MSF3Dprinting/SiliconeTubeDryingHolder/tools/sweep_report_2026-09-27.txt

# Parameter sweep — tube_holder.scad v2.0 — 2026-09-27 (openscad-fast Manifold + check_stl, sections Z 3,10,40,50)
# Every parameter at its min and max, one at a time; run in chunks and merged. GUARD = the model stopped itself with a
# plain-language assertion at that range end; PASS = exported, watertight, 1 body, checks OK. edge_r=max(3) first failed
# (the cove ring stood 0.55 mm off the sliced edge rounding); the cove profile now reaches 1 mm into the shelf — re-run PASS.
PASS   defaults                                    5.2s  check_stl warn: section at Z = 40.0: 6 separate pieces — expected if the part has several legs or walls here, a defect if the zone should be one piece; section at Z = 50.0: 6 separate pieces — expected if the part has several legs or walls here, a defect if the zone should be one piece
PASS   slot_n=min(1)                               2.4s  check_stl warn: section at Z = 40.0: 2 separate pieces — expected if the part has several legs or walls here, a defect if the zone should be one piece; section at Z = 50.0: 2 separate pieces — expected if the part has several legs or walls here, a defect if the zone should be one piece
GUARD  slot_n=max(8)                               0.4s  ERROR: Assertion '(((W <= (max_part[0] + 0.001)) && (plate_h <= max_part[1])) && ((plate_t + D) <= max_part[2]))' failed: "Part larger than 200 mm: fewer slots or a smaller pitch" in file /work/tube_holder.scad, line 122
PASS   slot_pitch=min(20)                          5.1s  check_stl warn: section at Z = 40.0: 6 separate pieces — expected if the part has several legs or walls here, a defect if the zone should be one piece; section at Z = 50.0: 6 separate pieces — expected if the part has several legs or walls here, a defect if the zone should be one piece
GUARD  slot_pitch=max(50)                          0.4s  ERROR: Assertion '(((W <= (max_part[0] + 0.001)) && (plate_h <= max_part[1])) && ((plate_t + D) <= max_part[2]))' failed: "Part larger than 200 mm: fewer slots or a smaller pitch" in file /work/tube_holder.scad, line 122
GUARD  pocket_1=min(3)                             0.4s  ERROR: Assertion '(pocket_d[k] > (pocket_d[(k + 1)] + 0.5))' failed: "pocket_d must go from the biggest tube (mouth) to the smallest (wall), each at least 0.5 mm smaller" in file /work/tube_holder.scad, line 107
PASS   pocket_1=max(16)                            5.2s  check_stl warn: section at Z = 40.0: 6 separate pieces — expected if the part has several legs or walls here, a defect if the zone should be one piece; section at Z = 50.0: 6 separate pieces — expected if the part has several legs or walls here, a defect if the zone should be one piece
GUARD  pocket_2=min(3)                             0.4s  ERROR: Assertion '(pocket_d[k] > (pocket_d[(k + 1)] + 0.5))' failed: "pocket_d must go from the biggest tube (mouth) to the smallest (wall), each at least 0.5 mm smaller" in file /work/tube_holder.scad, line 107
GUARD  pocket_2=max(16)                            0.4s  ERROR: Assertion '(pocket_d[k] > (pocket_d[(k + 1)] + 0.5))' failed: "pocket_d must go from the biggest tube (mouth) to the smallest (wall), each at least 0.5 mm smaller" in file /work/tube_holder.scad, line 107
GUARD  pocket_3=min(3)                             0.4s  ERROR: Assertion '(pocket_d[k] > (pocket_d[(k + 1)] + 0.5))' failed: "pocket_d must go from the biggest tube (mouth) to the smallest (wall), each at least 0.5 mm smaller" in file /work/tube_holder.scad, line 107
GUARD  pocket_3=max(16)                            0.4s  ERROR: Assertion '(pocket_d[k] > (pocket_d[(k + 1)] + 0.5))' failed: "pocket_d must go from the biggest tube (mouth) to the smallest (wall), each at least 0.5 mm smaller" in file /work/tube_holder.scad, line 107
PASS   pocket_4=min(2)                             5.1s  check_stl warn: section at Z = 40.0: 6 separate pieces — expected if the part has several legs or walls here, a defect if the zone should be one piece; section at Z = 50.0: 6 separate pieces — expected if the part has several legs or walls here, a defect if the zone should be one piece
GUARD  pocket_4=max(16)                            0.4s  ERROR: Assertion '(pocket_d[k] > (pocket_d[(k + 1)] + 0.5))' failed: "pocket_d must go from the biggest tube (mouth) to the smallest (wall), each at least 0.5 mm smaller" in file /work/tube_holder.scad, line 107
PASS   squeeze_top=min(2)                          5.1s  check_stl warn: section at Z = 40.0: 6 separate pieces — expected if the part has several legs or walls here, a defect if the zone should be one piece; section at Z = 50.0: 6 separate pieces — expected if the part has several legs or walls here, a defect if the zone should be one piece
PASS   squeeze_top=max(12)                         4.9s  check_stl warn: section at Z = 40.0: 6 separate pieces — expected if the part has several legs or walls here, a defect if the zone should be one piece; section at Z = 50.0: 6 separate pieces — expected if the part has several legs or walls here, a defect if the zone should be one piece
GUARD  squeeze_bottom=min(4)                       0.4s  ERROR: Assertion '(squeeze_bottom > squeeze_top)' failed: "squeeze_bottom must be larger than squeeze_top (the pocket narrows toward the bottom face)" in file /work/tube_holder.scad, line 108
PASS   squeeze_bottom=max(20)                      5.2s  check_stl warn: section at Z = 40.0: 6 separate pieces — expected if the part has several legs or walls here, a defect if the zone should be one piece; section at Z = 50.0: 6 separate pieces — expected if the part has several legs or walls here, a defect if the zone should be one piece
PASS   pocket_extra=min(2)                        10.6s  check_stl warn: section at Z = 40.0: 6 separate pieces — expected if the part has several legs or walls here, a defect if the zone should be one piece; section at Z = 50.0: 6 separate pieces — expected if the part has several legs or walls here, a defect if the zone should be one piece
PASS   shelf_t=min(12)                             5.1s  check_stl warn: section at Z = 40.0: 6 separate pieces — expected if the part has several legs or walls here, a defect if the zone should be one piece; section at Z = 50.0: 6 separate pieces — expected if the part has several legs or walls here, a defect if the zone should be one piece
PASS   shelf_t=max(26)                             5.2s  check_stl warn: section at Z = 40.0: 6 separate pieces — expected if the part has several legs or walls here, a defect if the zone should be one piece; section at Z = 50.0: 6 separate pieces — expected if the part has several legs or walls here, a defect if the zone should be one piece
PASS   bar_w=min(8)                                5.1s  check_stl warn: section at Z = 40.0: 6 separate pieces — expected if the part has several legs or walls here, a defect if the zone should be one piece; section at Z = 50.0: 6 separate pieces — expected if the part has several legs or walls here, a defect if the zone should be one piece
PASS   bar_w=max(25)                               5.2s  check_stl warn: section at Z = 40.0: 6 separate pieces — expected if the part has several legs or walls here, a defect if the zone should be one piece; section at Z = 50.0: 6 separate pieces — expected if the part has several legs or walls here, a defect if the zone should be one piece
GUARD  side_w=min(14)                              0.4s  ERROR: Assertion '(outer_w >= ((tip_r + corner_r) + 2))' failed: "Outer finger too thin: increase side_w to at least 15.2 mm" in file /work/tube_holder.scad, line 111
GUARD  side_w=max(40)                              0.4s  ERROR: Assertion '(((W <= (max_part[0] + 0.001)) && (plate_h <= max_part[1])) && ((plate_t + D) <= max_part[2]))' failed: "Part larger than 200 mm: fewer slots or a smaller pitch" in file /work/tube_holder.scad, line 122
PASS   pocket_extra=max(6)                        10.3s  check_stl warn: section at Z = 40.0: 6 separate pieces — expected if the part has several legs or walls here, a defect if the zone should be one piece; section at Z = 50.0: 6 separate pieces — expected if the part has several legs or walls here, a defect if the zone should be one piece
PASS   step_r=min(0.2)                            10.1s  check_stl warn: section at Z = 40.0: 6 separate pieces — expected if the part has several legs or walls here, a defect if the zone should be one piece; section at Z = 50.0: 6 separate pieces — expected if the part has several legs or walls here, a defect if the zone should be one piece
GUARD  step_r=max(1)                               0.8s  ERROR: Assertion '((2 * step_r) <= (((w_top(k) - w_top((k + 1))) / 2) - 0.05))' failed: "step_r too big for the step between the 10 and 8 mm pockets (0.94 mm deep): smaller step_r or bigger size steps" in file /work/tube_holder.scad, line 114
PASS   tip_r=min(2)                               10.4s  check_stl warn: section at Z = 40.0: 6 separate pieces — expected if the part has several legs or walls here, a defect if the zone should be one piece; section at Z = 50.0: 6 separate pieces — expected if the part has several legs or walls here, a defect if the zone should be one piece
PASS   tip_r=max(8)                               15.9s  check_stl warn: section at Z = 40.0: 6 separate pieces — expected if the part has several legs or walls here, a defect if the zone should be one piece; section at Z = 50.0: 6 separate pieces — expected if the part has several legs or walls here, a defect if the zone should be one piece
PASS   corner_r=min(3)                            15.9s  check_stl warn: section at Z = 40.0: 6 separate pieces — expected if the part has several legs or walls here, a defect if the zone should be one piece; section at Z = 50.0: 6 separate pieces — expected if the part has several legs or walls here, a defect if the zone should be one piece
PASS   corner_r=max(10)                           16.6s  check_stl warn: section at Z = 40.0: 6 separate pieces — expected if the part has several legs or walls here, a defect if the zone should be one piece; section at Z = 50.0: 6 separate pieces — expected if the part has several legs or walls here, a defect if the zone should be one piece
PASS   root_r=min(2)                              16.5s  check_stl warn: section at Z = 40.0: 6 separate pieces — expected if the part has several legs or walls here, a defect if the zone should be one piece; section at Z = 50.0: 6 separate pieces — expected if the part has several legs or walls here, a defect if the zone should be one piece
GUARD  root_r=max(12)                              1.3s  ERROR: Assertion '(bar_w >= ((root_r + 2) - 0.001))' failed: "bar_w must be at least root_r + 2 so the cove stays clear of the slot ends" in file /work/tube_holder.scad, line 115
GUARD  plate_t=min(4)                              1.2s  ERROR: Assertion '(plate_t >= (((ov + chamfer_top) + 0.3) - 0.001))' failed: "plate_t must be at least 4.1 mm so the buried back edge of the shelf stays inside it" in file /work/tube_holder.scad, line 117
PASS   plate_t=max(10)                            10.8s  check_stl warn: section at Z = 40.0: 6 separate pieces — expected if the part has several legs or walls here, a defect if the zone should be one piece; section at Z = 50.0: 6 separate pieces — expected if the part has several legs or walls here, a defect if the zone should be one piece
GUARD  plate_above=min(16)                         0.8s  ERROR: Assertion '((n_scr == 0) || (((screw_y - (screw_head_d / 2)) - 1) >= (((p_below + shelf_t) + root_r) - 0.001)))' failed: "Screws too close to the shelf: increase plate_above or reduce screw_edge" in file /work/tube_holder.scad, line 119
PASS   plate_above=max(60)                        10.4s  check_stl warn: section at Z = 40.0: 6 separate pieces — expected if the part has several legs or walls here, a defect if the zone should be one piece; section at Z = 50.0: 6 separate pieces — expected if the part has several legs or walls here, a defect if the zone should be one piece
PASS   plate_below=min(8)                         10.6s  check_stl warn: section at Z = 40.0: 6 separate pieces — expected if the part has several legs or walls here, a defect if the zone should be one piece; section at Z = 50.0: 6 separate pieces — expected if the part has several legs or walls here, a defect if the zone should be one piece
PASS   plate_below=max(40)                        10.7s  check_stl warn: section at Z = 40.0: 6 separate pieces — expected if the part has several legs or walls here, a defect if the zone should be one piece; section at Z = 50.0: 6 separate pieces — expected if the part has several legs or walls here, a defect if the zone should be one piece
PASS   plate_corner_r=min(3)                      10.7s  check_stl warn: section at Z = 40.0: 6 separate pieces — expected if the part has several legs or walls here, a defect if the zone should be one piece; section at Z = 50.0: 6 separate pieces — expected if the part has several legs or walls here, a defect if the zone should be one piece
PASS   plate_corner_r=max(12)                     10.3s  check_stl warn: section at Z = 40.0: 6 separate pieces — expected if the part has several legs or walls here, a defect if the zone should be one piece; section at Z = 50.0: 6 separate pieces — expected if the part has several legs or walls here, a defect if the zone should be one piece
PASS   screw_n=min(2)                              5.2s  check_stl warn: section at Z = 40.0: 6 separate pieces — expected if the part has several legs or walls here, a defect if the zone should be one piece; section at Z = 50.0: 6 separate pieces — expected if the part has several legs or walls here, a defect if the zone should be one piece
PASS   screw_n=max(3)                              5.1s  check_stl warn: section at Z = 40.0: 6 separate pieces — expected if the part has several legs or walls here, a defect if the zone should be one piece; section at Z = 50.0: 6 separate pieces — expected if the part has several legs or walls here, a defect if the zone should be one piece
PASS   screw_d=min(3)                              5.0s  check_stl warn: section at Z = 40.0: 6 separate pieces — expected if the part has several legs or walls here, a defect if the zone should be one piece; section at Z = 50.0: 6 separate pieces — expected if the part has several legs or walls here, a defect if the zone should be one piece
PASS   screw_d=max(6)                             10.2s  check_stl warn: section at Z = 40.0: 6 separate pieces — expected if the part has several legs or walls here, a defect if the zone should be one piece; section at Z = 50.0: 6 separate pieces — expected if the part has several legs or walls here, a defect if the zone should be one piece
PASS   screw_head_d=min(5)                        10.3s  check_stl warn: section at Z = 40.0: 6 separate pieces — expected if the part has several legs or walls here, a defect if the zone should be one piece; section at Z = 50.0: 6 separate pieces — expected if the part has several legs or walls here, a defect if the zone should be one piece
PASS   screw_head_d=max(12)                       10.5s  check_stl warn: section at Z = 40.0: 6 separate pieces — expected if the part has several legs or walls here, a defect if the zone should be one piece; section at Z = 50.0: 6 separate pieces — expected if the part has several legs or walls here, a defect if the zone should be one piece
PASS   screw_clr=min(0)                            5.4s  check_stl warn: section at Z = 40.0: 6 separate pieces — expected if the part has several legs or walls here, a defect if the zone should be one piece; section at Z = 50.0: 6 separate pieces — expected if the part has several legs or walls here, a defect if the zone should be one piece
PASS   screw_clr=max(1.5)                          5.0s  check_stl warn: section at Z = 40.0: 6 separate pieces — expected if the part has several legs or walls here, a defect if the zone should be one piece; section at Z = 50.0: 6 separate pieces — expected if the part has several legs or walls here, a defect if the zone should be one piece
PASS   screw_edge=min(8)                           5.1s  check_stl warn: section at Z = 40.0: 6 separate pieces — expected if the part has several legs or walls here, a defect if the zone should be one piece; section at Z = 50.0: 6 separate pieces — expected if the part has several legs or walls here, a defect if the zone should be one piece
GUARD  screw_edge=max(30)                          0.4s  ERROR: Assertion '((n_scr == 0) || (((screw_y - (screw_head_d / 2)) - 1) >= (((p_below + shelf_t) + root_r) - 0.001)))' failed: "Screws too close to the shelf: increase plate_above or reduce screw_edge" in file /work/tube_holder.scad, line 119
PASS   screw_spacing=min(30)                       5.3s  check_stl warn: section at Z = 40.0: 6 separate pieces — expected if the part has several legs or walls here, a defect if the zone should be one piece; section at Z = 50.0: 6 separate pieces — expected if the part has several legs or walls here, a defect if the zone should be one piece
PASS   screw_spacing=max(180)                      5.1s  check_stl warn: section at Z = 40.0: 6 separate pieces — expected if the part has several legs or walls here, a defect if the zone should be one piece; section at Z = 50.0: 6 separate pieces — expected if the part has several legs or walls here, a defect if the zone should be one piece
PASS   edge_r=min(0.8)                             5.4s  check_stl warn: section at Z = 40.0: 6 separate pieces — expected if the part has several legs or walls here, a defect if the zone should be one piece; section at Z = 50.0: 6 separate pieces — expected if the part has several legs or walls here, a defect if the zone should be one piece
PASS   edge_r=max(3)                               4.8s  check_stl warn: section at Z = 40.0: 6 separate pieces — expected if the part has several legs or walls here, a defect if the zone should be one piece; section at Z = 50.0: 6 separate pieces — expected if the part has several legs or walls here, a defect if the zone should be one piece
SUMMARY: 39 PASS, 16 GUARD, 0 FAIL of 55
