MSF3Dprinting/SiliconeTubeDryingHolder/img/tube_holder_exploded.png

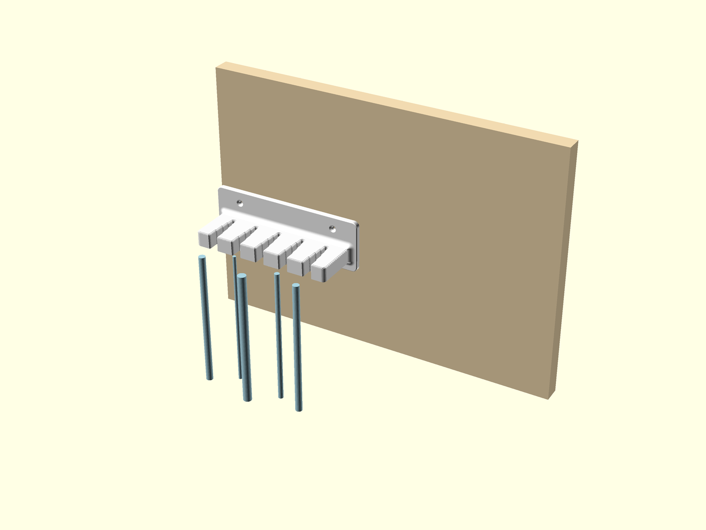
img/tube_holder_exploded.png
