MSF3Dprinting/SiliconeTubeDryingHolder/img/tube_holder_front.png

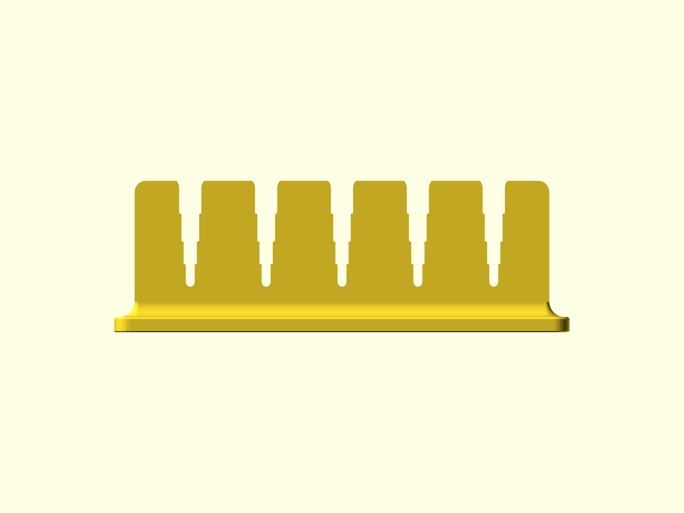
img/tube_holder_front.png
