MSF3Dprinting/SiliconeTubeDryingHolder/img/tube_holder_side.png

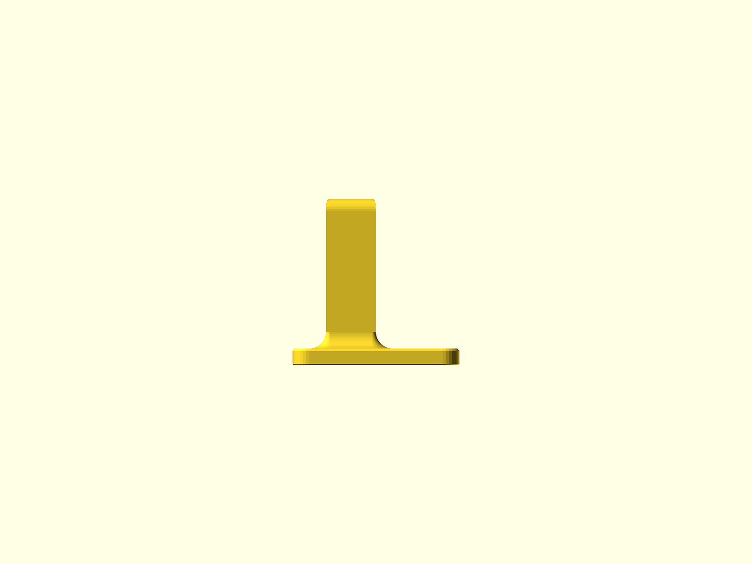
img/tube_holder_side.png
