MSF3Dprinting/SiliconeTubeDryingHolder/stl/tube_holder_holder_1_v2.0.stl

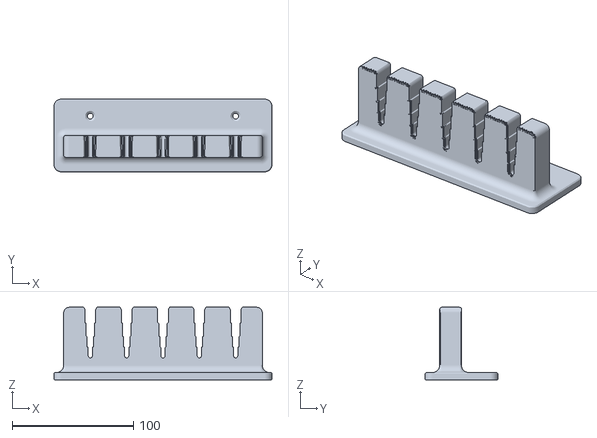
[picture p9: CAD file, 2026-11-09]
stl/tube_holder_holder_1_v2.0.stl
180.0 x 60.0 x 59.9
