MSF3Dprinting/SiliconeTubeDryingHolder/stl/tube_holder_test_slot_v2.0.stl

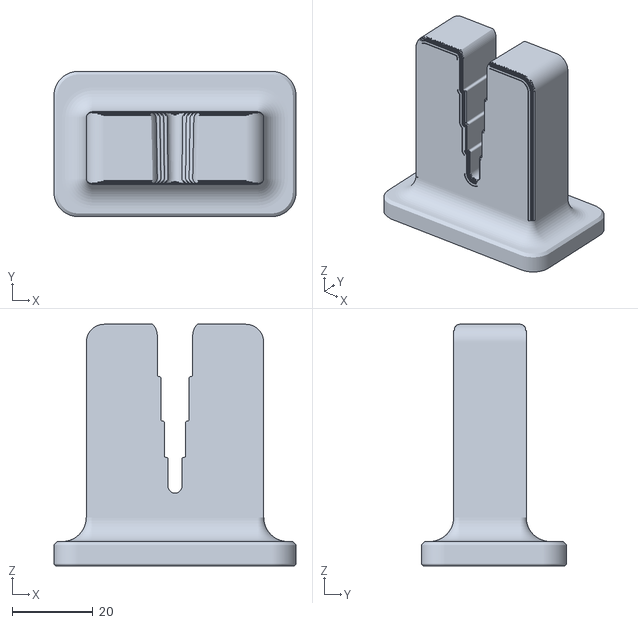
[picture p10: CAD file, 2026-11-09]
stl/tube_holder_test_slot_v2.0.stl
60.0 x 36.0 x 59.9
