MSF3Dprinting/SiliconeTubeDryingHolder/(list of files, cad)

Other CAD files:
tube_holder_customizer.scad
common.scad
helpers.scad
