MSF3Dprinting/SiliconeTubeDryingHolder/img/tube_holder_test_slot_front.png

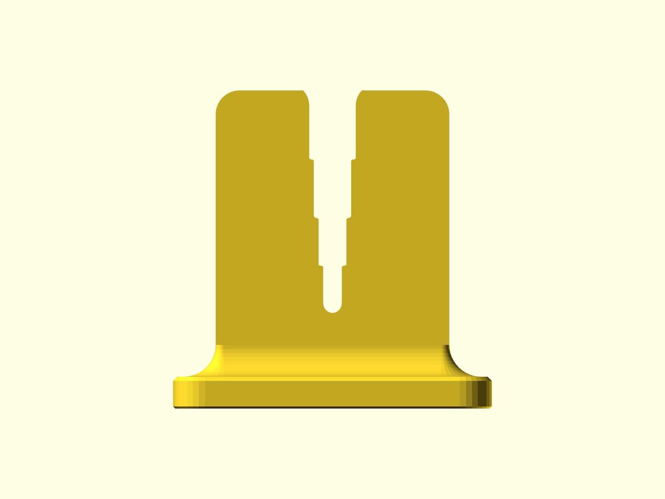
img/tube_holder_test_slot_front.png
