MSF3Dprinting/SiliconeTubeDryingHolder/img/tube_holder_test_slot_sheet.png

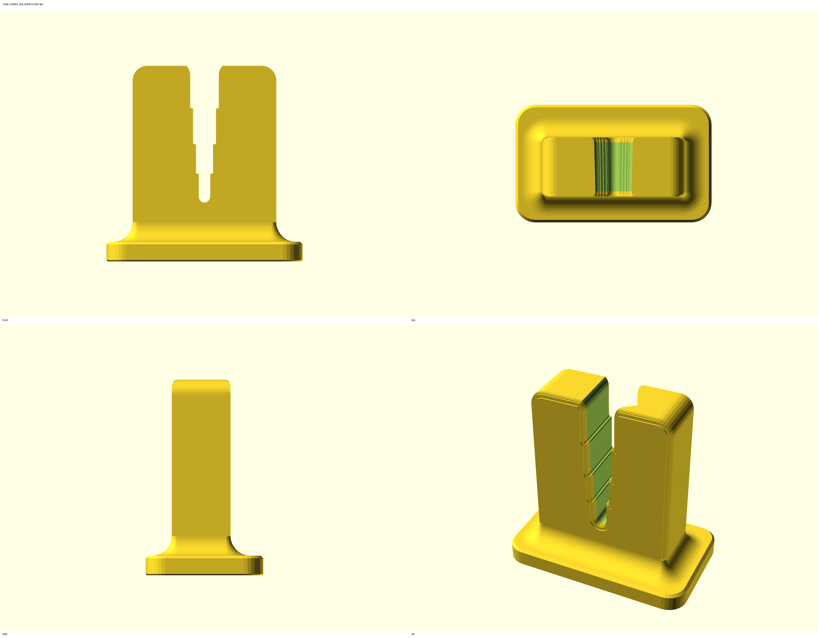
img/tube_holder_test_slot_sheet.png
