MSF3Dprinting/SiliconeTubeDryingHolder/img/tube_holder_test_slot_side.png

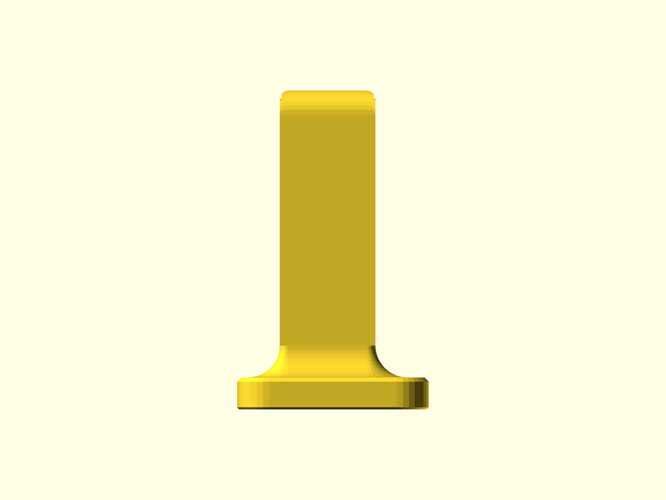
img/tube_holder_test_slot_side.png
