MSF3Dprinting/SiliconeTubeDryingHolder/img/tube_holder_test_slot_top.png

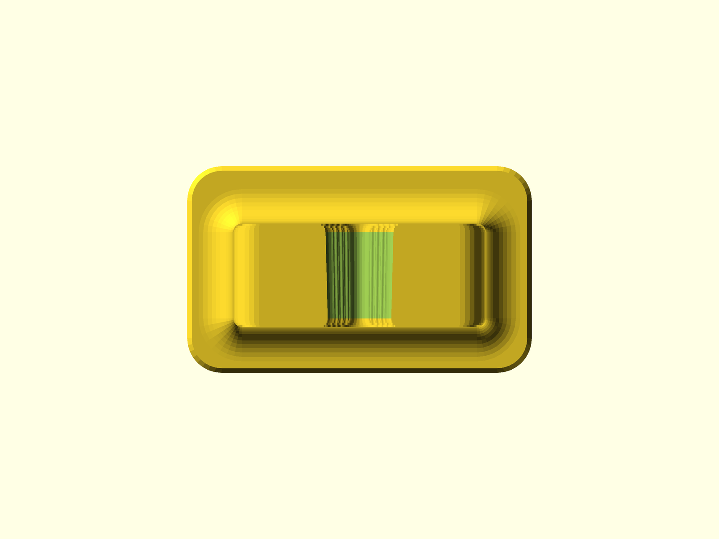
img/tube_holder_test_slot_top.png
